exzombie/teleskoper_dump/(commit log)

2011-05-24 Schematic, revision 0.6.
    [teleskoper.sch]
2011-05-24 Firmware for schematic version 0.4
2011-05-25 Minor comment fixes and removal of whitespace from blank lines.
    [teleskoper.asm]
